jcomega/DetectHeat/DetectHeat_Electronic_Board_Hardware/Pictures/Version_final1.jpg

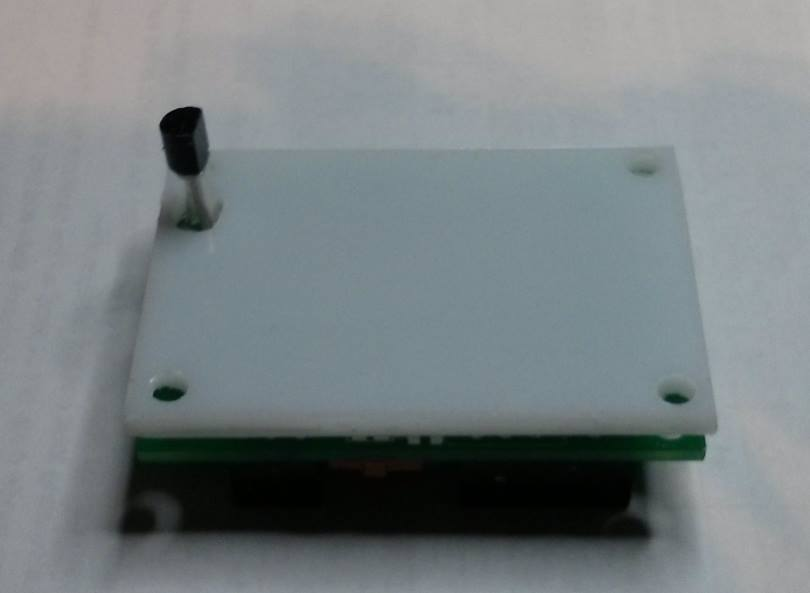
DetectHeat_Electronic_Board_Hardware/Pictures/Version_final1.jpg
