jcomega/DetectHeat/DetectHeat_Electronic_Board_Hardware/Pictures/All_PCB.JPG

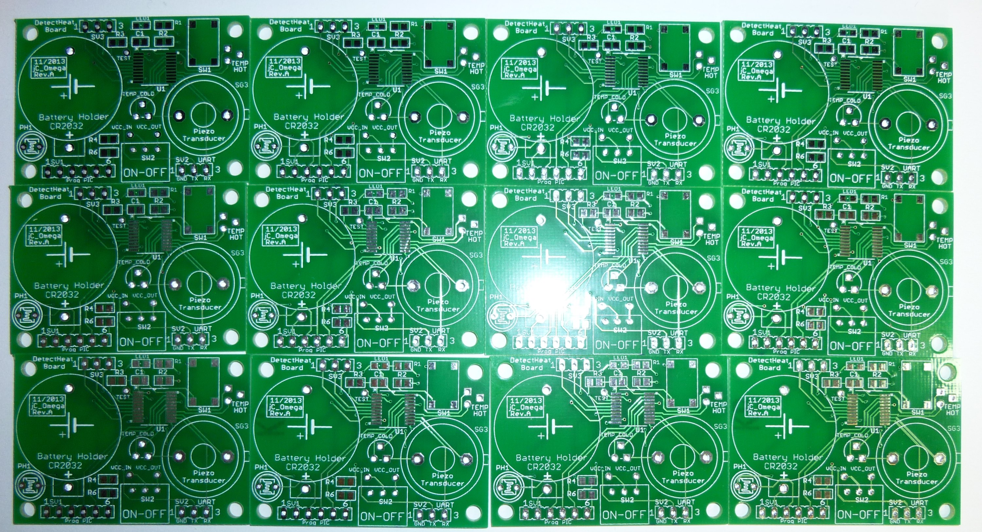
DetectHeat_Electronic_Board_Hardware/Pictures/All_PCB.JPG
