jcomega/DetectHeat/DetectHeat_Electronic_Board_Hardware/Doc/Piezo_buzzer.pdf

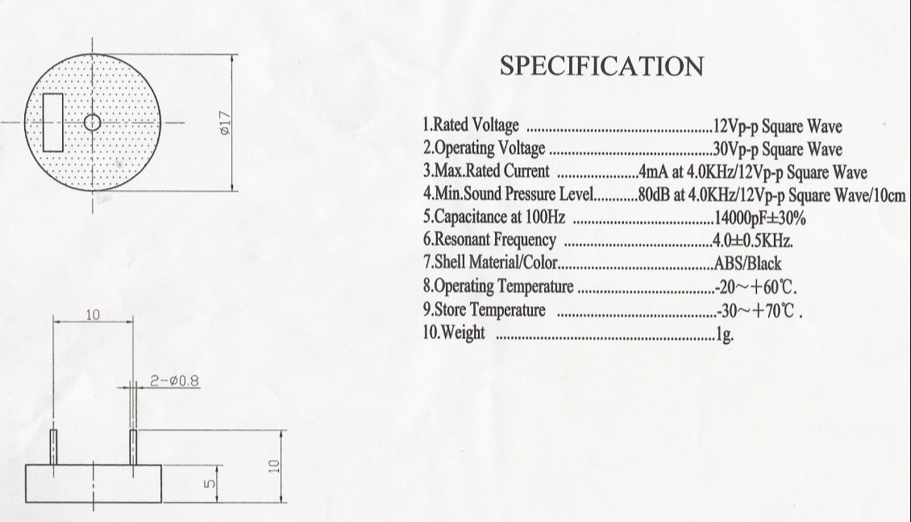
[picture p3: page 1]
