jcomega/DetectHeat/DetectHeat_Electronic_Board_Hardware/Pictures/2013-12-28 10.17.45.jpg

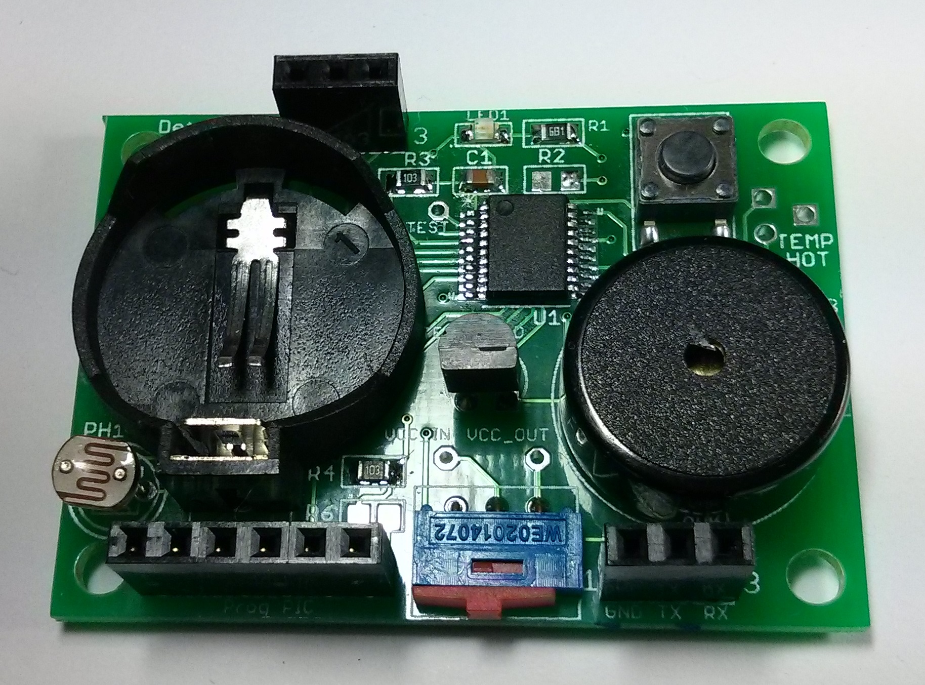
DetectHeat_Electronic_Board_Hardware/Pictures/2013-12-28 10.17.45.jpg
