jcomega/DetectHeat/DetectHeat_Electronic_Board_Hardware/Pictures/2013-12-28 18.13.32.jpg

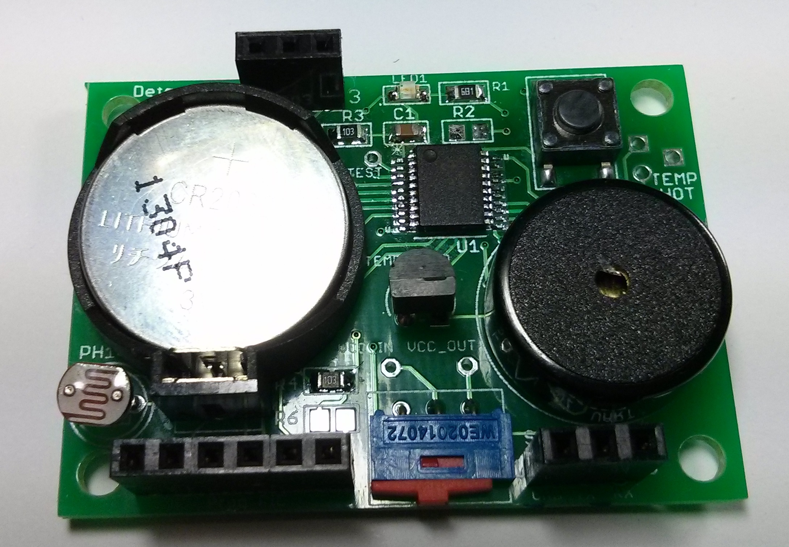
DetectHeat_Electronic_Board_Hardware/Pictures/2013-12-28 18.13.32.jpg
