jcomega/DetectHeat/DetectHeat_Electronic_Board_Hardware/Pictures/PCB_brute.JPG

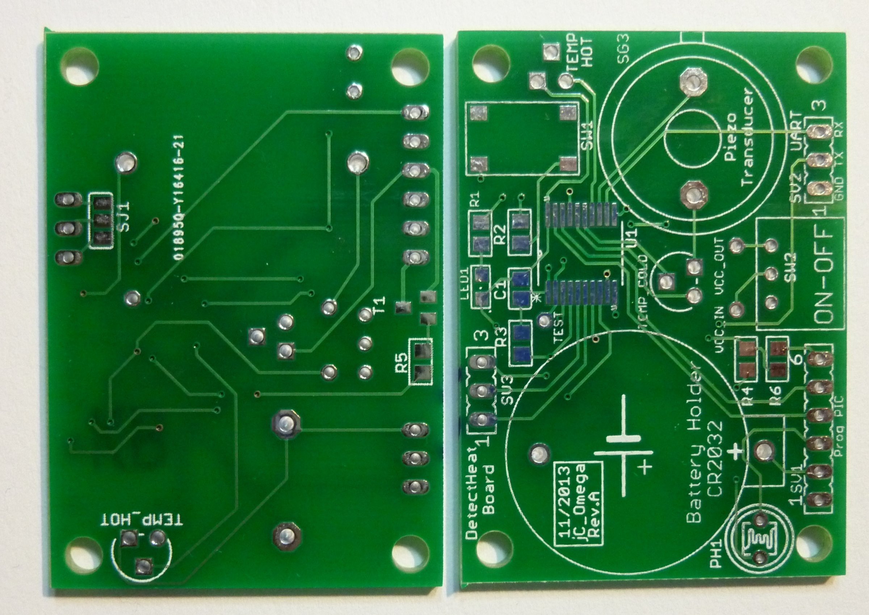
DetectHeat_Electronic_Board_Hardware/Pictures/PCB_brute.JPG
