jcomega/DetectHeat/DetectHeat_Electronic_Board_Hardware/Pictures/Version_final2.jpg

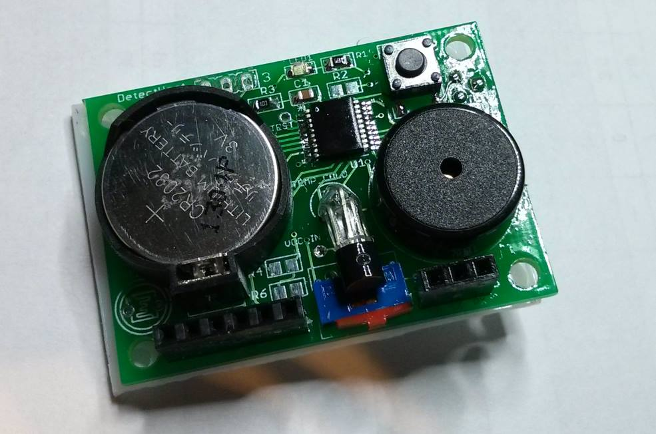
DetectHeat_Electronic_Board_Hardware/Pictures/Version_final2.jpg
