jcomega/DetectHeat/DetectHeat_Electronic_Board_Hardware/DetectHeat_Board_BOM_parts.xls

Pos | Qty | Part | Description | Value | Mounted on the PCB | Price (€) | Total Price (€) | Manufacturer | Manufacturer code | Supplier | Supplier code or link | Comments
1 | 1 | Battery Holder CR2032 | CR2032 CR2025 General Button Battery Clip Holder | Battery Holder CR2032 | Yes | 0.12 € | 0.12 € |  |  | ebay : joytownonline | Link (http://cgi.ebay.fr/10pcs-Portable-CR2032-CR2025-General-Button-Battery-Clip-Holder-Box-Case-JT1-/290983600162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)
2 | 1 | C1 | CAPACITOR | 100nF 50V | Yes | 0.01 € | 0.01 €
3 | 1 | LED1 | LED | Super green LED 0805 | Yes | 0.07 € | 0.07 € |  |  | ebay : tedchen1632 | Link (http://cgi.ebay.fr/100pcs-lot-0805-Ultra-Bright-SMD-Super-Green-LED-/201053341000?pt=LH_DefaultDomain_0)
4 | 1 | PH1 | PHOTO RESISTOR GL5528 | PHOTO RESISTOR | No (option) | 0.40 € | 0.00 € |  |  | ebay : onibuy | link (http://www.ebay.fr/itm/10pcs-Photoresistance-GL5528-LDR-Resistance-Dependant-de-Lumiere-/271298302218)
5 | 1 | R1 | RESISTOR 5% 0805 | 680 | Yes | 0.01 € | 0.01 €
6 | 1 | R2 | RESISTOR 5% 0805 | 68K | No | 0.01 € | 0.00 €
7 | 1 | R3 | RESISTOR 5% 0805 | 10K | Yes | 0.01 € | 0.01 €
8 | 1 | R4 | RESISTOR 5% 0805 | 47K | Yes | 0.01 € | 0.01 €
9 | 1 | R5 | RESISTOR 5% 0805 | 1K | No | 0.01 € | 0.00 €
10 | 1 | R6 | RESISTOR 5% 0805 | 0R | No | 0.01 € | 0.00 €
11 | 1 | SG3 | Miniature PCB Mounting Piezo Transducer 12Vdc 80dB | Piezo Transducer 12Vdc 80dB | Yes | 1.20 € | 1.20 € |  |  | ebay : spiratronics | Link (http://cgi.ebay.fr/Miniature-PCB-Mounting-Piezo-Transducer-12Vdc-80dB-2pk-/300936458447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) | Doc link (http://www.spiratronics.com/data/4730.pdf)
12 | 1 | SV1 | FEMALE HEADER | 2.54mm Pin Sockets 6pts | Yes | 0.05 € | 0.05 € |  |  | http://www.fasttech.com/ | Link (https://www.fasttech.com/products/1011500) | Must be cut
13 | 1 | SV2 | FEMALE HEADER | 2.54mm Pin Sockets 3pts | Yes | 0.05 € | 0.05 € |  |  | http://www.fasttech.com/ | Link (https://www.fasttech.com/products/1011500) | Must be cut
14 | 1 | SV3 | FEMALE HEADER | 2.54mm Pin Sockets 3pts | No (option) | 0.05 € | 0.00 € |  |  | http://www.fasttech.com/ | Link (https://www.fasttech.com/products/1011500) | Must be cut
15 | 1 | SW1 | WS-TSS-6x6 mm SMD Tact Switch,4 pins | 430182043816 | Yes |  | 0.00 € | wurth elektronik |  | wurth elektronik | Farnell Link (http://fr.farnell.com/wurth-elektronik/430182043816/switch-160gf-6x6mm-smd-4-3mm-act/dp/2065105) | Sample doc (http://katalog.we-online.de/kataloge/eican/media/pdf/4301x2.pdf)
16 | 1 | SW2 | WS-SUT, 10mm*2.5mm, SPDT, ON-ON, 2.54mm, right angle type, THT, Mini Slide Switch, 3 pins | 450302014072 | Yes |  | 0.00 € | wurth elektronik |  | wurth elektronik | Farnell link (http://fr.farnell.com/wurth-elektronik/450302014072/commutateur-slide-mini-on-on-right/dp/2134453) | Sample doc (http://katalog.we-online.de/kataloge/eican/media/pdf/450302014072.pdf)
17 | 1 | T1 | NPN TRANSISTOR | MMBT2222 | No (option) | 0.02 € | 0.00 € |  |  | ebay : czb6721960 | Link (http://cgi.ebay.fr/100PCS-MMBT2222A-MMBT2222-SOT-23-2N2222-SMD-NPN-Transistor-/140892090229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)
18 | 2 | TEMP_HOT, TEMP_COLD | THERMISTOR, LINEAR 10MV/C | MCP9700A-E/TO | Yes | 0.25 € | 0.50 € | Microchip |  | Microchip | Link (http://www.microchip.com/wwwproducts/Devices.aspx?product=MCP9700A) | Sample
19 | 1 | U1 | Flash Microcontrollers | PIC18LF14K22-I/SS | Yes | 1.50 € | 1.50 € | Microchip |  | Microchip | Link (http://www.microchip.com/wwwproducts/Devices.aspx?product=PIC18F14K22) | Sample
20 | 1 |  | PCB | PCB, FR4, 1,6mm, green soldermask, HASL, White silkscreen, 49x35mm | Yes | 1.00 € | 1.00 € | seeedstudio |  | http://www.seeedstudio.com/ | Link (http://www.seeedstudio.com/service/index.php?r=site/pcbService)
21 | 1 |  | Battery | CR2032 | Yes | 0.32 € | 0.32 € | Sony | Sony | http://www.fasttech.com/ | Link (http://www.fasttech.com/products/0/10002553/1189503-authentic-sony-cr2032-3v-cell-buttons-batteries-5-)
 |  |  |  |  |  |  | Total for this Board :
 |  |  |  |  |  |  | 4.85 €
