jcomega/DetectHeat/DetectHeat_Electronic_Board_Hardware/Pictures/With_components.JPG

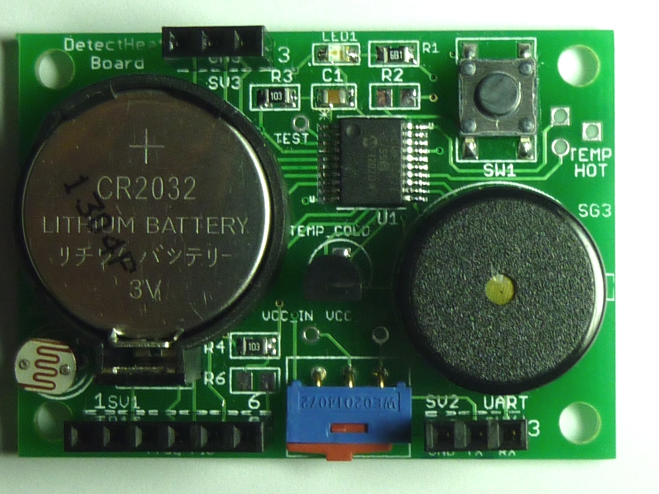
DetectHeat_Electronic_Board_Hardware/Pictures/With_components.JPG
