jcomega/DetectHeat/DetectHeat_Electronic_Board_Hardware/Pictures/install1.jpg

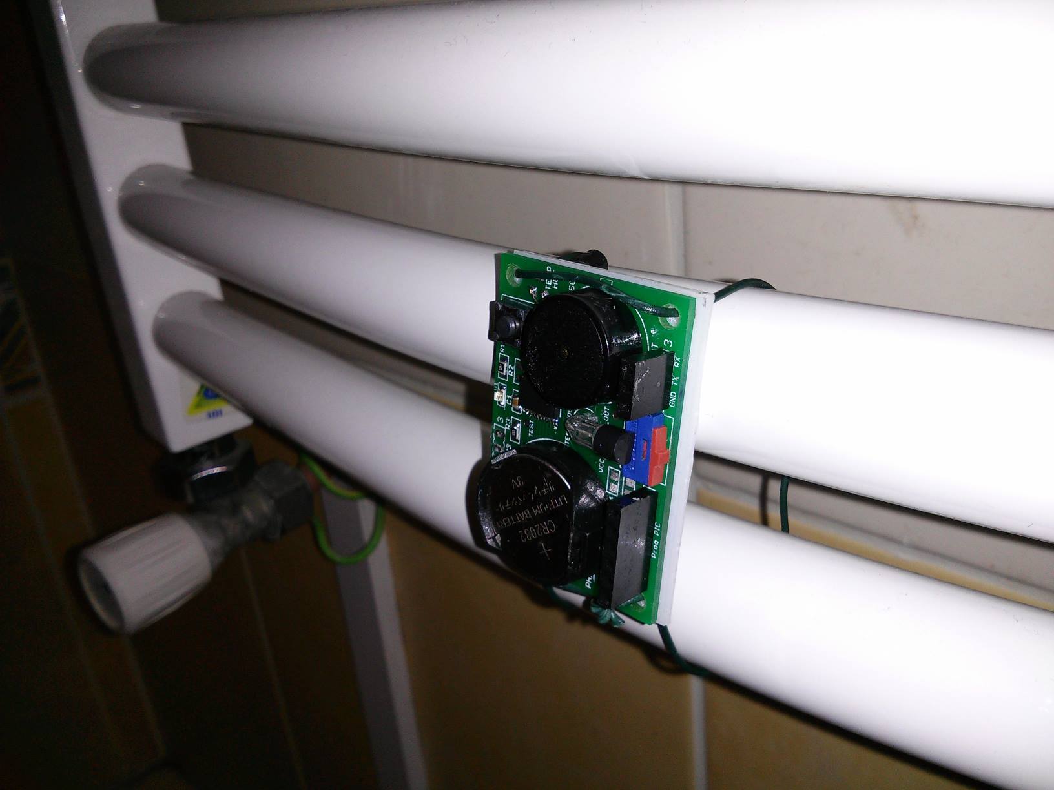
DetectHeat_Electronic_Board_Hardware/Pictures/install1.jpg
