jcomega/DetectHeat/DetectHeat_Electronic_Board_Hardware/Pictures/install2.jpg

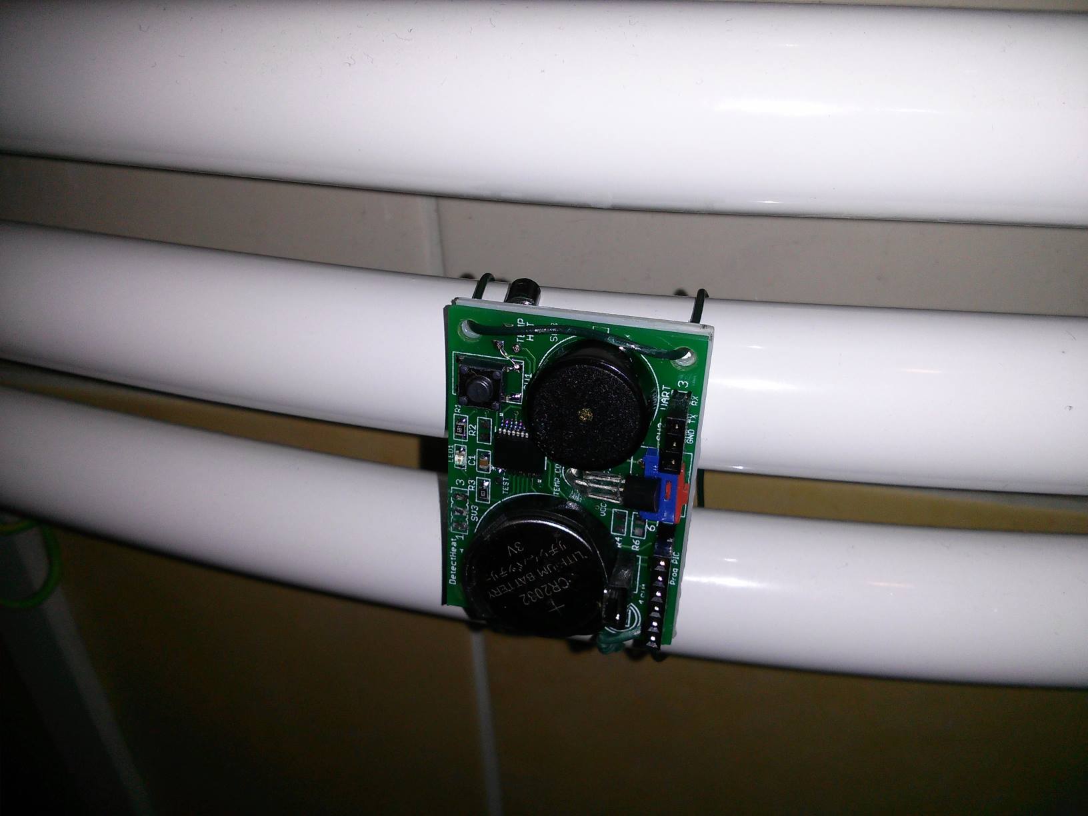
DetectHeat_Electronic_Board_Hardware/Pictures/install2.jpg
