jcomega/DetectHeat/DetectHeat_Electronic_Board_Hardware/DetectHeat_Board/DetectHeat_drawing.pdf

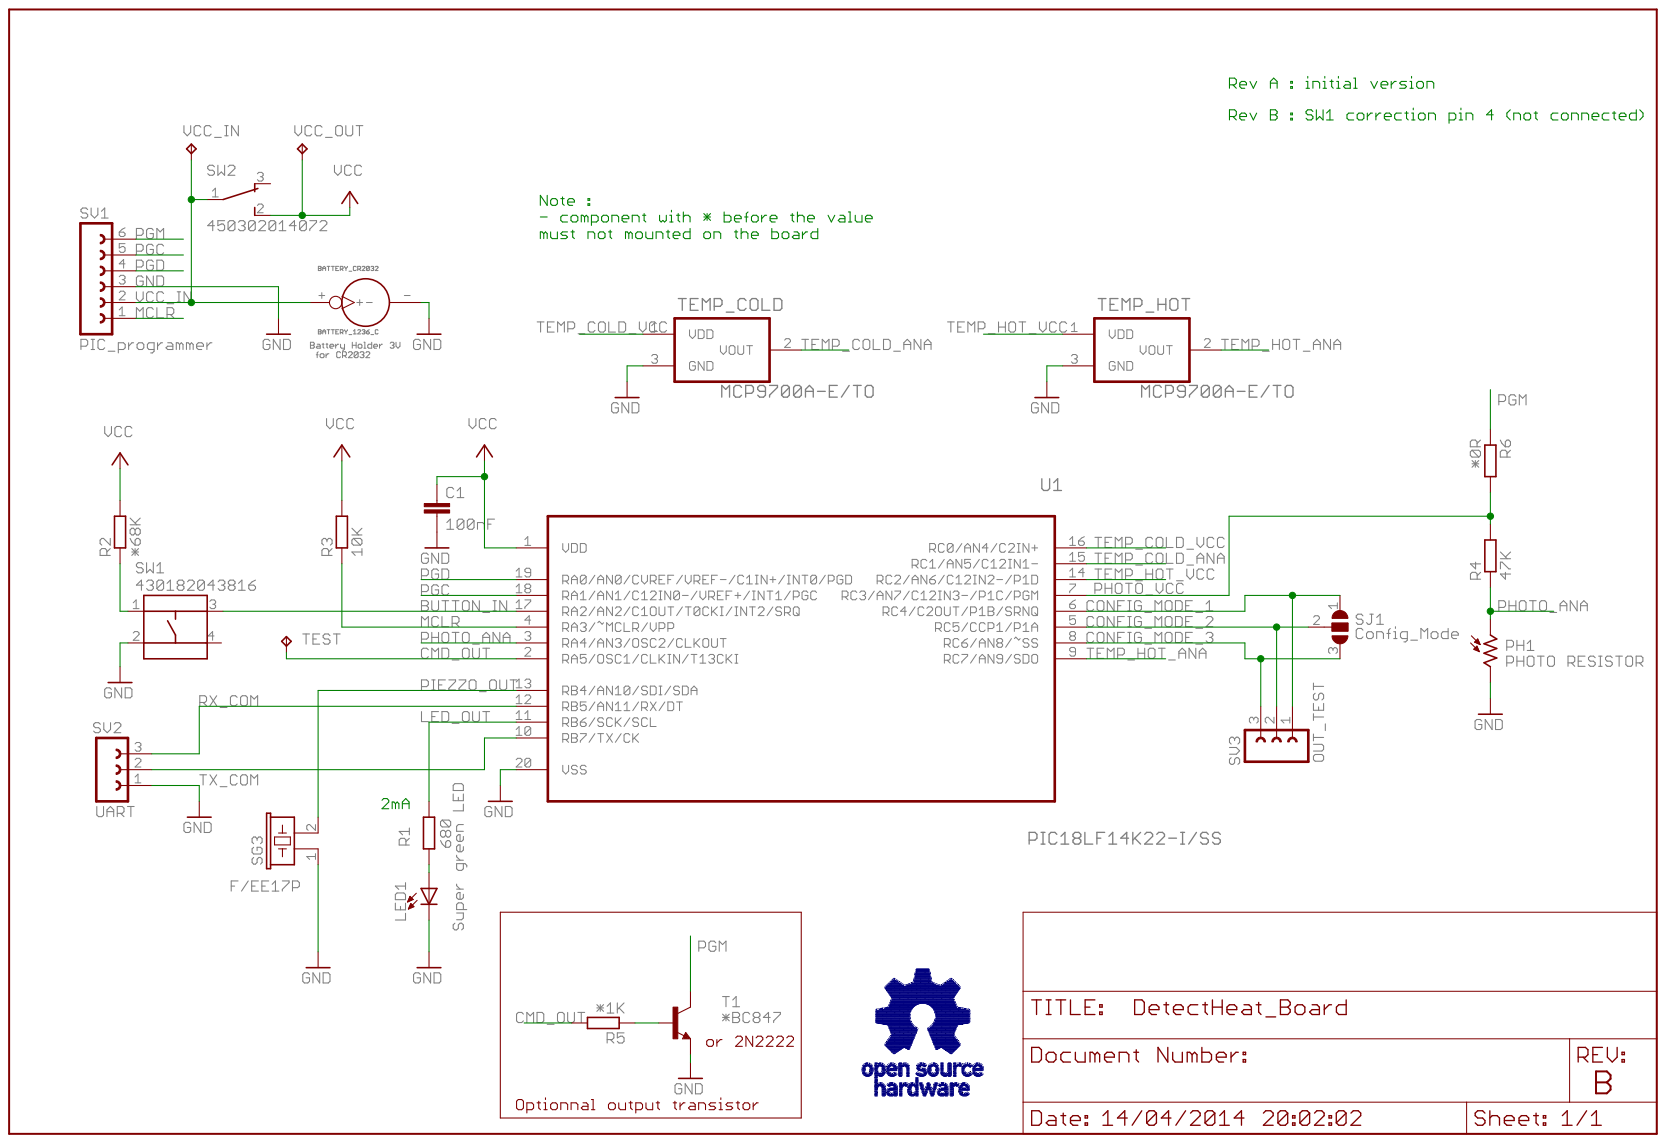
[picture p11: page 1]
