jcomega/DetectHeat/DetectHeat_Electronic_Board_Hardware/DetectHeat_Board/DetectHeat_Board.pdf

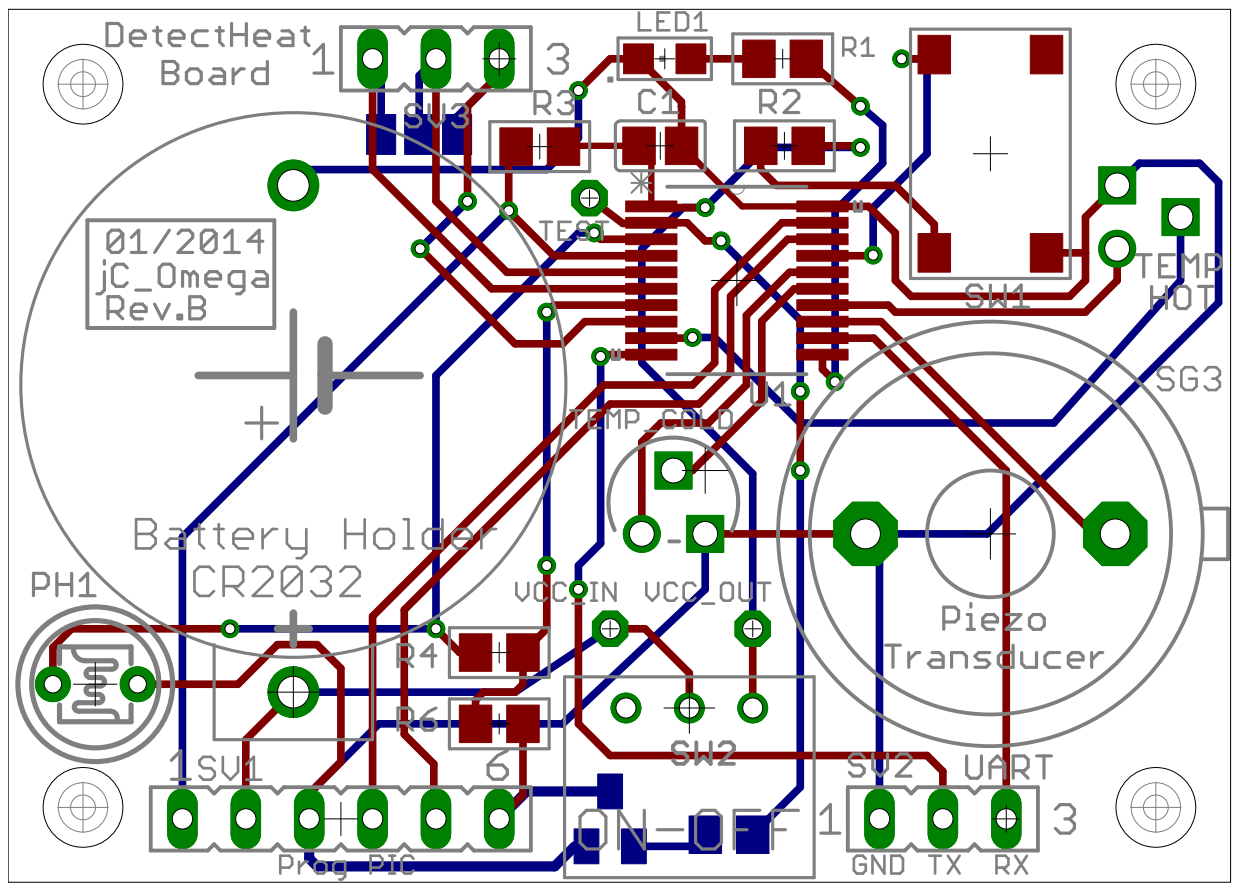
[picture p12: page 1]
