jcomega/DetectHeat/DetectHeat_Electronic_Board_Hardware/Doc/cr2032_battery_holder.pdf

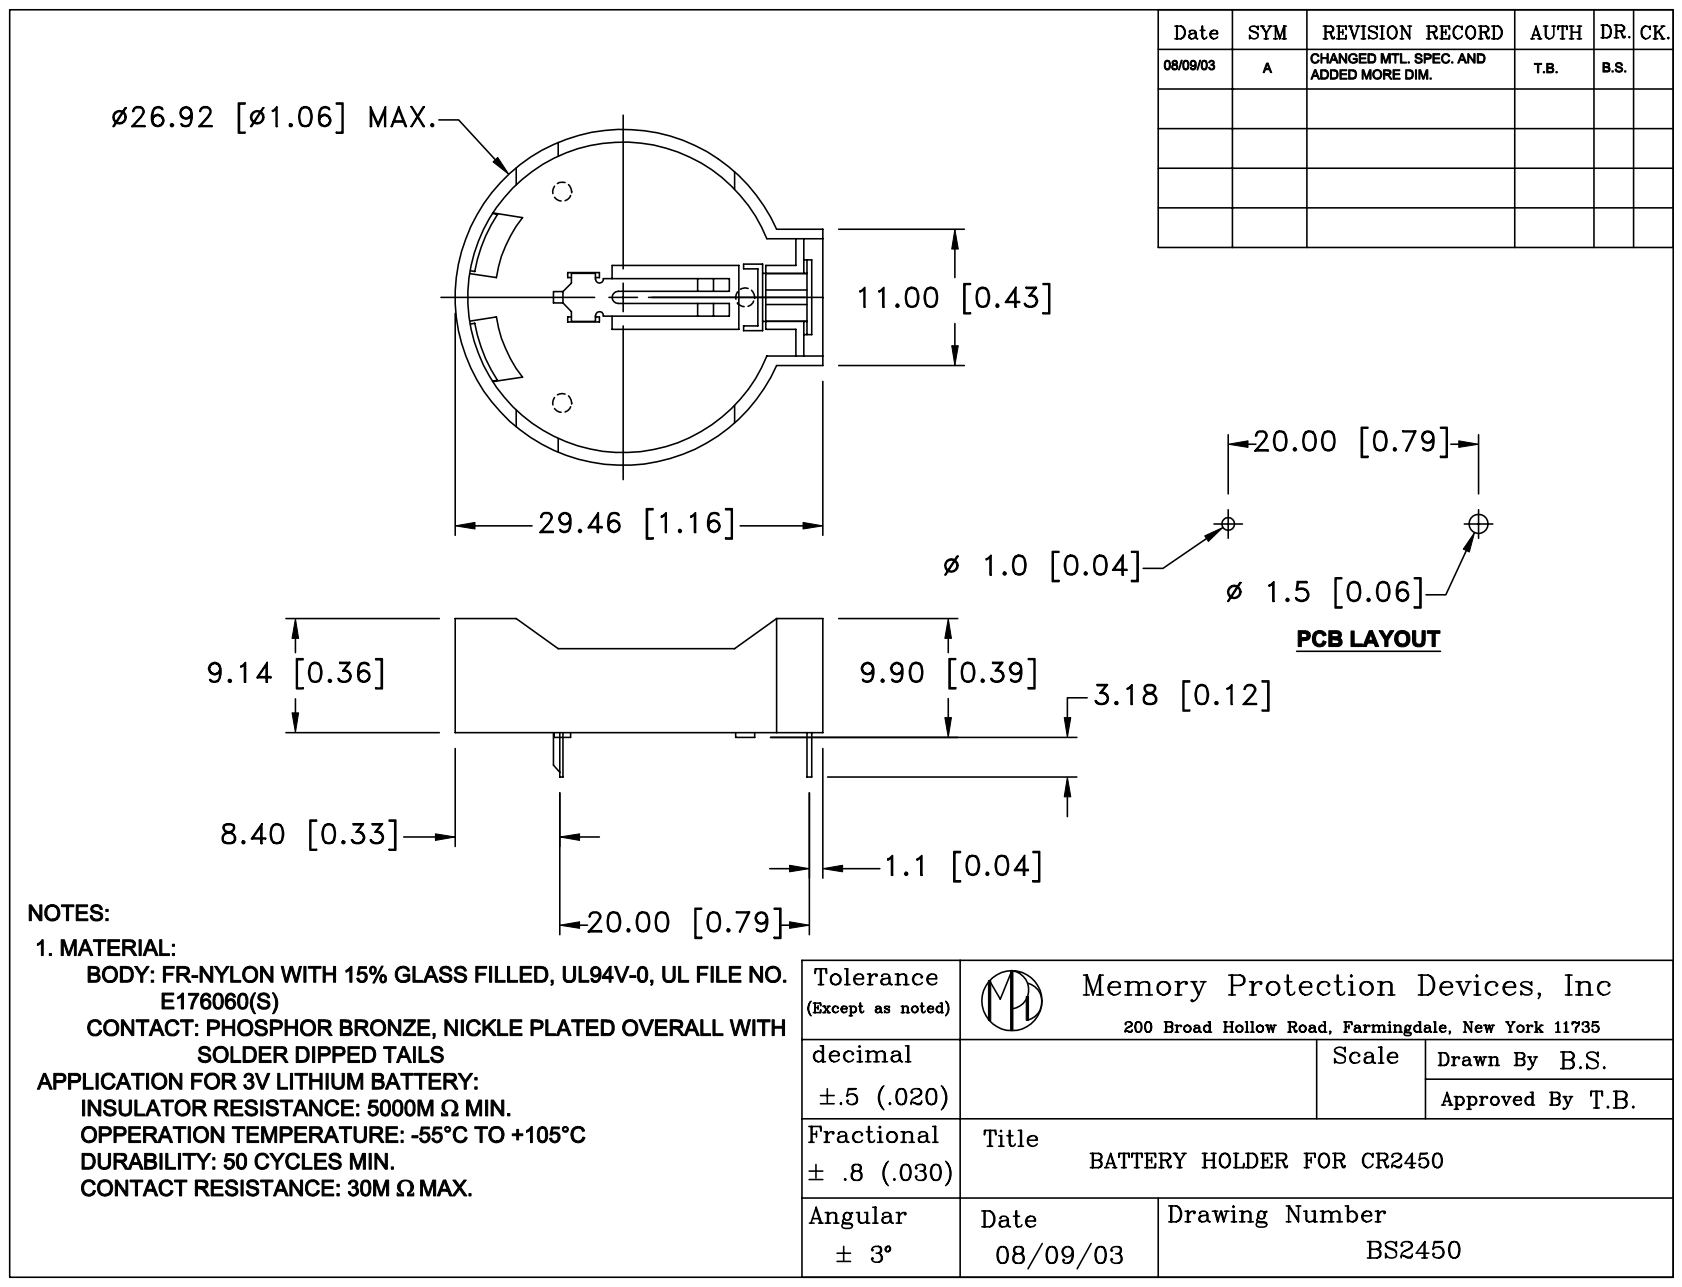
[picture p13: page 1]
