jcomega/DetectHeat/DetectHeat_Electronic_Board_Hardware/DetectHeat_Board/DetectHeat_Board.brd

## EAGLE design DetectHeat_Electronic_Board_Hardware/DetectHeat_Board/DetectHeat_Board.brd (2014-04-14)

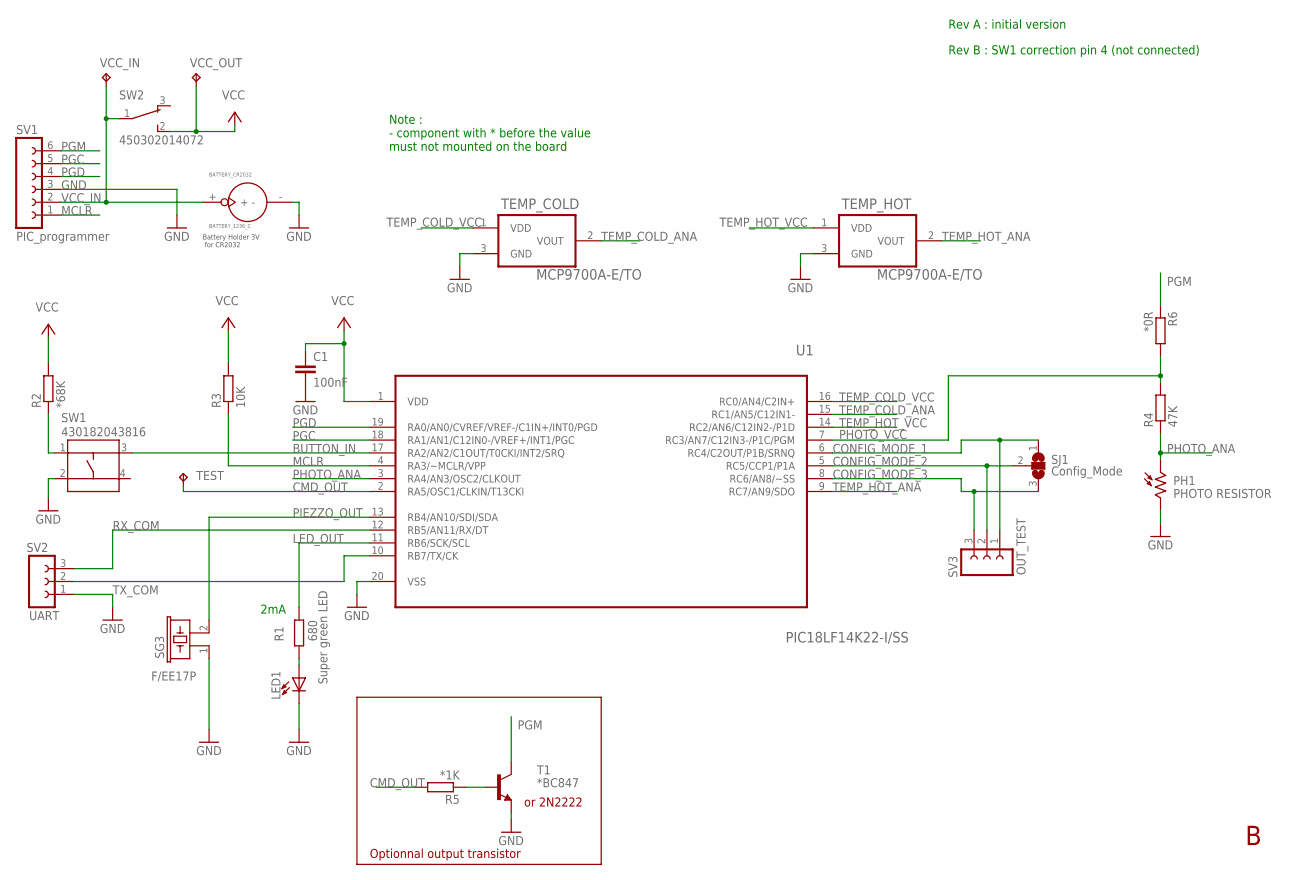
[picture p14: schematic DetectHeat_Board.sch]

Parts:
BATTERY_CR2032: BATTERY_1236_C
C1: 100nF; C0805
LED1: Super green LED; CHIPLED_0805
PH1: PHOTO RESISTOR; T0-46-A10XX
R1: 680; R0805
R2: *68K; R0805
R3: 10K; R0805
R4: 47K; R0805
R5: *1K; R0805
R6: *0R; R0805
SG3: F/EE17P
SJ1: Config_Mode; SJ_2
SV1: PIC_programmer; FE06
SV2: UART; FE03-1
SV3: OUT_TEST; FE03-1
SW1: 430182043816
SW2: 450302014072
T1: *BC847; SOT23
TEMP_COLD: MCP9700A-E/TO; TO127P254X533-3
TEMP_HOT: MCP9700A-E/TO; TO127P254X533-3
TEST: TPPAD1-13; P1-13
U1: PIC18LF14K22-I/SS; SOP65P780X200-20N
VCC_IN: TPPAD1-13; P1-13
VCC_OUT: TPPAD1-13; P1-13

Connections:
BUTTON_IN: SW1.3, U1.17 (RA2/AN2/C1OUT/T0CKI/INT2/SRQ)
CMD_OUT: R5.2, TEST.TP, U1.2 (RA5/OSC1/CLKIN/T13CKI)
CONFIG_MODE_1: SJ1.1, SV3.1, U1.6 (RC4/C2OUT/P1B/SRNQ)
CONFIG_MODE_2: SJ1.2, SV3.2, U1.5 (RC5/CCP1/P1A)
CONFIG_MODE_3: SJ1.3, SV3.3, U1.8 (RC6/AN8/~SS)
GND: BATTERY_CR2032.-, C1.2, LED1.C, PH1.2, SG3.1, SV1.3, SV2.1, SW1.2, T1.2 (E), TEMP_COLD.3 (GND), TEMP_HOT.3 (GND), U1.20 (VSS)
LED_OUT: R1.1, U1.11 (RB6/SCK/SCL)
MCLR: R3.1, SV1.1, U1.4 (RA3/~MCLR/VPP)
unnamed: LED1.A, R1.2
unnamed: R5.1, T1.1 (B)
unnamed: R2.1, SW1.1
PGC: SV1.5, U1.18 (RA1/AN1/C12IN0-/VREF+/INT1/PGC)
PGD: SV1.4, U1.19 (RA0/AN0/CVREF/VREF-/C1IN+/INT0/PGD)
PGM: R6.1, SV1.6, T1.3 (C)
PHOTO_ANA: PH1.1, R4.1, U1.3 (RA4/AN3/OSC2/CLKOUT)
PHOTO_VCC: R4.2, R6.2, U1.7 (RC3/AN7/C12IN3-/P1C/PGM)
PIEZZO_OUT: SG3.2, U1.13 (RB4/AN10/SDI/SDA)
RX_COM: SV2.3, U1.12 (RB5/AN11/RX/DT)
TEMP_COLD_ANA: TEMP_COLD.2 (VOUT), U1.15 (RC1/AN5/C12IN1-)
TEMP_COLD_VCC: TEMP_COLD.1 (VDD), U1.16 (RC0/AN4/C2IN+)
TEMP_HOT_ANA: TEMP_HOT.2 (VOUT), U1.9 (RC7/AN9/SDO)
TEMP_HOT_VCC: TEMP_HOT.1 (VDD), U1.14 (RC2/AN6/C12IN2-/P1D)
TX_COM: SV2.2, U1.10 (RB7/TX/CK)
VCC: C1.1, R2.2, R3.2, SW2.2, U1.1 (VDD), VCC_OUT.TP
VCC_IN: BATTERY_CR2032.+, SV1.2, SW2.1, VCC_IN.TP

Notes on the sheet:
Note : - component with * before the value must not mounted on the board
2mA
Battery Holder 3V for CR2032
Optionnal output transistor
or 2N2222
Rev A : initial version
Rev B : SW1 correction pin 4 (not connected)

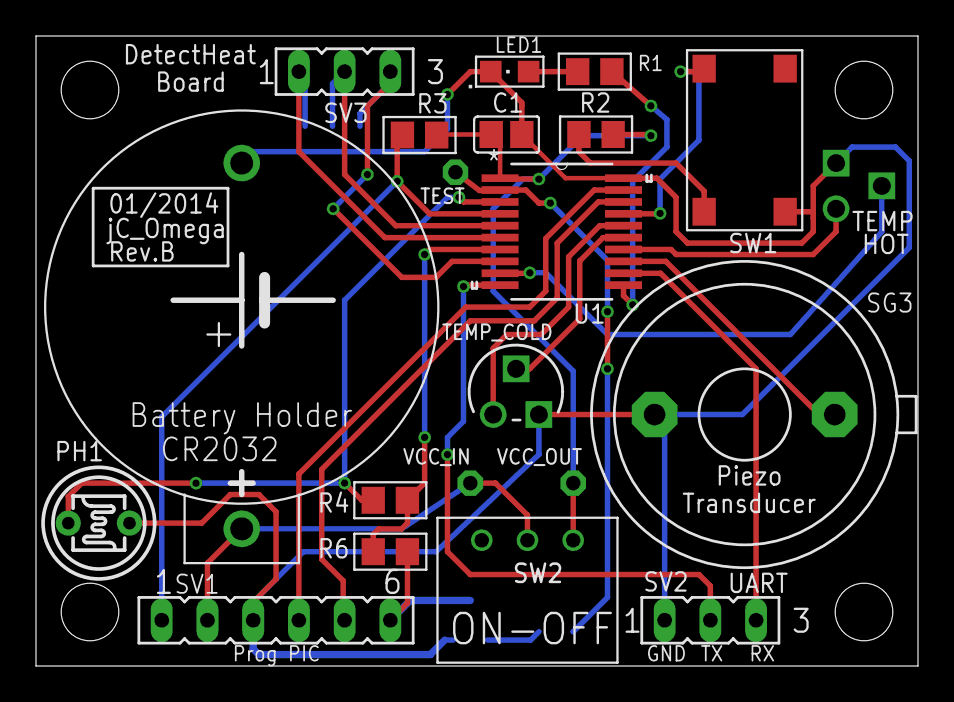
[picture p15: board DetectHeat_Board.brd from above]

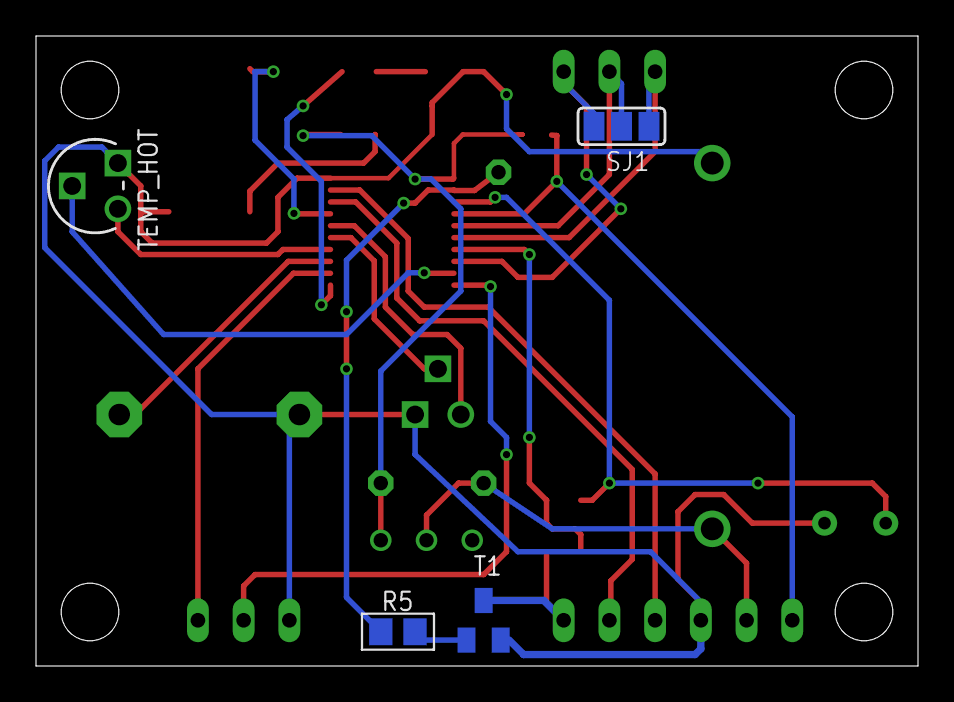
[picture p16: board DetectHeat_Board.brd from below]

Board: 4 copper layers, 49.0 x 35.0 mm, 24 parts (4 on the bottom side), 25 nets.
