jcomega/DetectHeat/DetectHeat_Electronic_Board_Software/DetectHeat/Sources/RTTTLtone.c

/*****************************************************************************/
/*                                                                           */
/*       RTTTL Ring Tone Player for Microchip PIC16F87x Microcontrollers     */
/*                   Copyright Craig.Peacock@beyondlogic.org                 */
/*                       Version 1.0 17th August 2003                        */
/*    http://retired.beyondlogic.org/pic/ringtones.htm
/*                                                                           */
/*****************************************************************************/

#include "../Includes/device.h"
#include "../Includes/RTTTLtone.h"
#include "../Includes/tick.h"
//#include <stdio.h>

#define OCTAVE_OFFSET 0

#pragma udata   // declare statically allocated uinitialized variables

unsigned char beep;
unsigned char preloadTMRL;
unsigned char preloadTMRH;

//const rom char song[]  = "The Simpsons:d=4,o=5,b=160:c.6,e6,f#6,8a6,g.6,e6,c6,8a,8f#,8f#,8f#,2g,8p,8p,8f#,8f#,8f#,8g,a#.,8c6,8c6,8c6,c6";
//const rom char song[]  = "Indiana:d=4,o=5,b=250:e,8p,8f,8g,8p,1c6,8p.,d,8p,8e,1f,p.,g,8p,8a,8b,8p,1f6,p,a,8p,8b,2c6,2d6,2e6,e,8p,8f,8g,8p,1c6,p,d6,8p,8e6,1f.6,g,8p,8g,e.6,8p,d6,8p,8g,e.6,8p,d6,8p,8g,f.6,8p,e6,8p,8d6,2c6";
//const rom char song[]  = "TakeOnMe:d=4,o=4,b=160:8f#5,8f#5,8f#5,8d5,8p,8b,8p,8e5,8p,8e5,8p,8e5,8g#5,8g#5,8a5,8b5,8a5,8a5,8a5,8e5,8p,8d5,8p,8f#5,8p,8f#5,8p,8f#5,8e5,8e5,8f#5,8e5,8f#5,8f#5,8f#5,8d5,8p,8b,8p,8e5,8p,8e5,8p,8e5,8g#5,8g#5,8a5,8b5,8a5,8a5,8a5,8e5,8p,8d5,8p,8f#5,8p,8f#5,8p,8f#5,8e5,8e5";
//const rom char song[]  = "Entertainer:d=4,o=5,b=140:8d,8d#,8e,c6,8e,c6,8e,2c.6,8c6,8d6,8d#6,8e6,8c6,8d6,e6,8b,d6,2c6,p,8d,8d#,8e,c6,8e,c6,8e,2c.6,8p,8a,8g,8f#,8a,8c6,e6,8d6,8c6,8a,2d6";
//const rom char song[]  = "Muppets:d=4,o=5,b=250:c6,c6,a,b,8a,b,g,p,c6,c6,a,8b,8a,8p,g.,p,e,e,g,f,8e,f,8c6,8c,8d,e,8e,8e,8p,8e,g,2p,c6,c6,a,b,8a,b,g,p,c6,c6,a,8b,a,g.,p,e,e,g,f,8e,f,8c6,8c,8d,e,8e,d,8d,c";
//const rom char song[]  = "Xfiles:d=4,o=5,b=125:e,b,a,b,d6,2b.,1p,e,b,a,b,e6,2b.,1p,g6,f#6,e6,d6,e6,2b.,1p,g6,f#6,e6,d6,f#6,2b.,1p,e,b,a,b,d6,2b.,1p,e,b,a,b,e6,2b.,1p,e6,2b.";
//const rom char song[]  = "Looney:d=4,o=5,b=140:32p,c6,8f6,8e6,8d6,8c6,a.,8c6,8f6,8e6,8d6,8d#6,e.6,8e6,8e6,8c6,8d6,8c6,8e6,8c6,8d6,8a,8c6,8g,8a#,8a,8f";
//const rom char song[]  = "20thCenFox:d=16,o=5,b=140:b,8p,b,b,2b,p,c6,32p,b,32p,c6,32p,b,32p,c6,32p,b,8p,b,b,b,32p,b,32p,b,32p,b,32p,b,32p,b,32p,b,32p,g#,32p,a,32p,b,8p,b,b,2b,4p,8e,8g#,8b,1c#6,8f#,8a,8c#6,1e6,8a,8c#6,8e6,1e6,8b,8g#,8a,2b";
//const rom char song[]  = "Bond:d=4,o=5,b=80:32p,16c#6,32d#6,32d#6,16d#6,8d#6,16c#6,16c#6,16c#6,16c#6,32e6,32e6,16e6,8e6,16d#6,16d#6,16d#6,16c#6,32d#6,32d#6,16d#6,8d#6,16c#6,16c#6,16c#6,16c#6,32e6,32e6,16e6,8e6,16d#6,16d6,16c#6,16c#7,c.7,16g#6,16f#6,g#.6";
//const rom char song[]  = "MASH:d=8,o=5,b=140:4a,4g,f#,g,p,f#,p,g,p,f#,p,2e.,p,f#,e,4f#,e,f#,p,e,p,4d.,p,f#,4e,d,e,p,d,p,e,p,d,p,2c#.,p,d,c#,4d,c#,d,p,e,p,4f#,p,a,p,4b,a,b,p,a,p,b,p,2a.,4p,a,b,a,4b,a,b,p,2a.,a,4f#,a,b,p,d6,p,4e.6,d6,b,p,a,p,2b";
//const rom char song[]  = "StarWars:d=4,o=5,b=45:32p,32f#,32f#,32f#,8b.,8f#.6,32e6,32d#6,32c#6,8b.6,16f#.6,32e6,32d#6,32c#6,8b.6,16f#.6,32e6,32d#6,32e6,8c#.6,32f#,32f#,32f#,8b.,8f#.6,32e6,32d#6,32c#6,8b.6,16f#.6,32e6,32d#6,32c#6,8b.6,16f#.6,32e6,32d#6,32e6,8c#6";
//const rom char song[]  = "GoodBad:d=4,o=5,b=56:32p,32a#,32d#6,32a#,32d#6,8a#.,16f#.,16g#.,d#,32a#,32d#6,32a#,32d#6,8a#.,16f#.,16g#.,c#6,32a#,32d#6,32a#,32d#6,8a#.,16f#.,32f.,32d#.,c#,32a#,32d#6,32a#,32d#6,8a#.,16g#.,d#";
//const rom char song[]  = "TopGun:d=4,o=4,b=31:32p,16c#,16g#,16g#,32f#,32f,32f#,32f,16d#,16d#,32c#,32d#,16f,32d#,32f,16f#,32f,32c#,16f,d#,16c#,16g#,16g#,32f#,32f,32f#,32f,16d#,16d#,32c#,32d#,16f,32d#,32f,16f#,32f,32c#,g#";
//const rom char song[]  = "A-Team:d=8,o=5,b=125:4d#6,a#,2d#6,16p,g#,4a#,4d#.,p,16g,16a#,d#6,a#,f6,2d#6,16p,c#.6,16c6,16a#,g#.,2a#";
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
{"smario2:d=4,o=5,b=125:8g,16c,8e,8g.,16c,8e,16g,16c,16e,16g,8b,a,8p,16c,8g,16c,8e,8g.,16c,8e,16g,16c#,16e,16g,8b,a,8p,16b,8c6,16b,8c6,8a.,16c6,8b,16a,8g,16f#,8g,8e.,16c,8d,16e,8f,16e,8f,8b.4,16e,8d.,c"},
{"smb3lvl1:d=4,o=5,b=80:16g,32c,16g.,16a,32c,16a.,16b,32c,16b,16a.,32g#,16a.,16g,32c,16g.,16a,32c,16a,4b.,32p,16c6,32f,16c.6,16d6,32f,16d.6,16e6,32f,16e6,16d.6,32c#6,16d.6,16c6,32f,16c.6,16d6,32f,16d6,4e.6,32p,16g,32c,16g.,16a,32c,16a.,16b,32c,16b,16a.,32g#,16a.,16c6,8c.6,32p,16c6,4c.6"},
{"shinobi:d=4,o=5,b=140:b,f#6,d6,b,g,f#,e,2f#.,a,1f#,p,b,f#6,d6,b,g,f#,e,1f#.,8a,1b.,8a,1f#.,8a,1b.,8a,1f#."},
{"outrun_magic:d=4,o=5,b=160:f6,d#6,8g#.6,f6,d#6,8c#.6,d#6,c6,2g#.,c#6,c6,8d#.6,c#6,c6,8f.,a#,16c.6,1a#,f6,d#6,8g#.6,f6,d#6,8c#.6,d#6,c6,2g#.,c#6,c6,8d#.6,c#6,c6,16f.,16g#.,c6,2a#."},
{"Popeye:d=4,o=5,b=140:16g.,16f.,16g.,16p,32p,16c.,16p,32p,16c.,16p,32p,16e.,16d.,16c.,16d.,16e.,16f.,g,8p,16a,16f,16a,16c6,16b,16a,16g,16a,16g,8e,16g,16g,16g,16g,8a,16b,32c6,32b,32c6,32b,32c6,32b,8c6"},
{"Wonderboy:d=4,o=5,b=225:f6,d6,f6,8d6,f6,32p,8f6,d6,f6,d6,e6,c6,e6,8c6,e6,32p,8e6,c6,e6,c6"},
{"smwwd1:d=4,o=5,b=125:a,8f.,16c,16d,16f,16p,f,16d,16c,16p,16f,16p,16f,16p,8c6,8a.,g,16c,a,8f.,16c,16d,16f,16p,f,16d,16c,16p,16f,16p,16a#,16a,16g,2f,16p,8a.,8f.,8c,8a.,f,16g#,16f,16c,16p,8g#.,2g,8a.,8f.,8c,8a.,f,16g#,16f,8c,2c6"},
{"dkong:d=4,o=5,b=160:2c,8d.,d#.,c.,16b,16c6,16b,16c6,16b,16c6,16b,16c6,16b,16c6,16b,16c6,16b,2c6"}};
*/




const rom int notes[] = { 0,
NOTE_C4, NOTE_CS4, NOTE_D4, NOTE_DS4, NOTE_E4, NOTE_F4, NOTE_FS4, NOTE_G4, NOTE_GS4, NOTE_A4, NOTE_AS4, NOTE_B4,
NOTE_C5, NOTE_CS5, NOTE_D5, NOTE_DS5, NOTE_E5, NOTE_F5, NOTE_FS5, NOTE_G5, NOTE_GS5, NOTE_A5, NOTE_AS5, NOTE_B5,
NOTE_C6, NOTE_CS6, NOTE_D6, NOTE_DS6, NOTE_E6, NOTE_F6, NOTE_FS6, NOTE_G6, NOTE_GS6, NOTE_A6, NOTE_AS6, NOTE_B6,
NOTE_C7, NOTE_CS7, NOTE_D7, NOTE_DS7, NOTE_E7, NOTE_F7, NOTE_FS7, NOTE_G7, NOTE_GS7, NOTE_A7, NOTE_AS7, NOTE_B7
};

#pragma code    // declare executable instructions

//--------------------------------------------------------------------------------------------------------------------------------------------
/*! \fn  void RTTTL_Start_PlayNote(unsigned short note, unsigned char octave, unsigned int duration)void ADC_Init(void)
 *  \brief This fonction initialise the ADC
 *  \param note : Select the note
 *  \param octave : Select octove
 *  \param duration : Select duration
 *  \return none
 */
//--------------------------------------------------------------------------------------------------------------------------------------------
void RTTTL_Start_PlayNote(unsigned short note, unsigned char octave, unsigned int duration)
{

    RTTTL_Enable(); // enable RTTL module
    /* Process octave */
    switch (octave) {
        case 4 : /* Do noting */
             break;
        case 5 : /* %2 */
             note = note >> 1;
             break;
        case 6 : /* %4 */
             note = note >> 2;
             break;
        case 7 : /* %8 */
             note = note >> 4;
             break;
    }
    /* Wait until last note has played */
    //while(TMR0Count) { };
    beep = 0;

    /* Process New Note Frequency */
    if (note) {
        note = ~note;
        preloadTMRL = (note & 0xFF);
        preloadTMRH = ((note & 0xFF00) >> 8);
    }

    /* Process Note Duration */
    //TMR0Count = 255/(duration & 0x7F);

    /* If duration is 1.5x add .5 to duration */
    //if (duration & 0x80) TMR0Count = (TMR0Count + (TMR0Count >> 1));

    if (note) beep = 1;
    TICK_Set(TICK_NOTE_DURATION,duration);
    //while(!TICK_Is_Elapse(TICK_NOTE_DURATION));

}
//------------------------------------------------------------------------------
/*! \fn    unsigned char RTTTL_IsPlaying_PlayNote(void)
 *  \brief  Test if the playing note is finished
 *
 *  \return unsigned char :  return 1 if the note is playing, return 0 if the note is finished
 */
//------------------------------------------------------------------------------
unsigned char RTTTL_IsPlaying_PlayNote(void)
{
    if (TICK_Is_Elapse(TICK_NOTE_DURATION))  return 0;  // return 0 if the note is finished
    else return 1;   // return 1 if the note is playing
}
//------------------------------------------------------------------------------
/*! \fn    void RTTTL_Stop_PlayNote(void)
 *  \brief  Stop play note
 *  \return void
 */
//------------------------------------------------------------------------------
void RTTTL_Stop_PlayNote(void)
{
    beep=0;
    RTTTL_Disable(); // Disable RTTL module
    PIEZZO_OUT = 0;
}
//------------------------------------------------------------------------------
/*! \fn    void RTTTL_Beep(void)
 *  \brief  Change piezzo state and reload timer
 *  \return void
 */
//------------------------------------------------------------------------------
void RTTTL_Beep(void)
{
    if (beep==1) { PIEZZO_OUT = !PIEZZO_OUT;   }
    else      { PIEZZO_OUT = 0; }
    TMR3H = preloadTMRH;
    TMR3L = preloadTMRL;
    PIR2bits.TMR3IF = 0;          // clear roll-over interrupt flag
}
//------------------------------------------------------------------------------
/*! \fn    void RTTTL_Init(void)
 *  \brief  Initialise the RTTTL module (timer3)
 *  \return void
 */
//------------------------------------------------------------------------------
void RTTTL_Init(void)
{

        // Timer3 Registers:
    // Prescaler=1:1; TMR3 Preset=47354; Freq=439,9956Hz; Period=2 272 750 ns
    T3CONbits.T3CKPS1 = 0;// bits 5-4  Prescaler Rate Select bits
    T3CONbits.T3CKPS0 = 0;//
    T3CONbits.T3SYNC  = 1;// bit 2 Timer3 External Clock Input Synchronization Control bit: 1=Do not synchronize external clock input
    T3CONbits.TMR3CS  = 0;// bit 1 Timer3 Clock Source Select bit:0=Internal clock (FOSC/4)
    T3CONbits.TMR3ON  = 0;// bit 0 enables timer


    TMR3H = 0xB8;       // preset for timer3 MSB register
    TMR3L = 0xFA;       // preset for timer3 LSB register
    preloadTMRH = 0xB8;
    preloadTMRL = 0xFA;


    // interrupt Timer3 config
    PIR2bits.TMR3IF = 0;          // clear roll-over interrupt flag
    IPR2bits.TMR3IP = 0;         // Timer0 is low priority interrupt
    PIE2bits.TMR3IE = 0;          // enable the Timer0 interrupt.
    
    beep =0; //buzzer off at starting
    CONF_PIEZZO_OUT = 0;  // output
    PIEZZO_OUT = 0;       // output off
}
//------------------------------------------------------------------------------
/*! \fn    void play_rtttl(rom const char *p)
 *  \brief  Play the music in rom
 *  \param *p : adress in rom for the music
 *  \return void
 */
//------------------------------------------------------------------------------
void play_rtttl(rom const char *p)
{
  // Absolutely no error checking in here
  unsigned char default_dur = 4;
  unsigned char  default_oct = 6;
  int bpm = 63;
  int num;
  long wholenote;
  long duration;
  unsigned char  note;
  unsigned char  scale;

  // format: d=N,o=N,b=NNN:
  // find the start (skip name, etc)

  while(*p != ':') p++;    // ignore name
  p++;                     // skip ':'

  // get default duration
  if(*p == 'd')
  {
    p++; p++;              // skip "d="
    num = 0;
    while(isdigit(*p))
    {
      num = (num * 10) + (*p++ - '0');
    }
    if(num > 0) default_dur = num;
    p++;                   // skip comma
  }
  // get default octave
  if(*p == 'o')
  {
    p++; p++;              // skip "o="
    num = *p++ - '0';
    if(num >= 3 && num <=7) default_oct = num;
    p++;                   // skip comma
  }

  // get BPM
  if(*p == 'b')
  {
    p++; p++;              // skip "b="
    num = 0;
    while(isdigit(*p))
    {
      num = (num * 10) + (*p++ - '0');
    }
    bpm = num;
    p++;                   // skip colon
  }

  // BPM usually expresses the number of quarter notes per minute
  wholenote = (60 * 1000L / bpm) * 4;  // this is the time for whole note (in milliseconds)

  // now begin note loop
  while(*p)
  {
    // first, get note duration, if available
    num = 0;
    while(isdigit(*p))
    {
      num = (num * 10) + (*p++ - '0');
    }

    if(num) duration = wholenote / num;
    else duration = wholenote / default_dur;  // we will need to check if we are a dotted note after

    // now get the note
    note = 0;

    switch(*p)
    {
      case 'c':
        note = 1;
        break;
      case 'd':
        note = 3;
        break;
      case 'e':
        note = 5;
        break;
      case 'f':
        note = 6;
        break;
      case 'g':
        note = 8;
        break;
      case 'a':
        note = 10;
        break;
      case 'b':
        note = 12;
        break;
      case 'p':
      default:
        note = 0;
    }
    p++;

    // now, get optional '#' sharp
    if(*p == '#')
    {
      note++;
      p++;
    }

    // now, get optional '.' dotted note
    if(*p == '.')
    {
      duration += duration/2;
      p++;
    }

    // now, get scale
    if(isdigit(*p))
    {
      scale = *p - '0';
      p++;
    }
    else
    {
      scale = default_oct;
    }

    scale += OCTAVE_OFFSET;

    if(*p == ',')
      p++;       // skip comma for next note (or we may be at the end)

    // now play the note

        if(note>0) RTTTL_Start_PlayNote(notes[(scale - 4) * 12 + note], 4, duration);
        else RTTTL_Start_PlayNote(0, 4, duration);   //pause
        while (RTTTL_IsPlaying_PlayNote());
            //RTTTL_Stop_PlayNote();
    ClrWdt();
  }
RTTTL_Stop_PlayNote();
}
