jcomega/DetectHeat/(commit log)

2014-04-12 first commit v2
    [DetectHeat_Board.GBL, DetectHeat_Board.GBO, DetectHeat_Board.GBP, DetectHeat_Board.GBS, DetectHeat_Board.GTL, DetectHeat_Board.GTO, DetectHeat_Board.GTP, DetectHeat_Board.GTS]
2014-04-14 add Bill of material for the board
    [DetectHeat_Board_BOM_parts.xls, Nomenclature.xlsx]
2014-04-14 correct little mistake : PIC reference
    PIC18F14K22 --> PIC18LF14K22 (low energy)
    [DetectHeat_Board.brd, DetectHeat_Board.sch, DetectHeat_Board_BOM_parts.xls]
