jcomega/DetectHeat/(notices)

Notices in the files:
parts and their libraries:
Eagle_Wuerth_Elektronik_Switch_Power_Ele: Copyright: Würth Elektronik
